walthowd/Philips-ep3200-ha/images/ESP12E-pinout.png

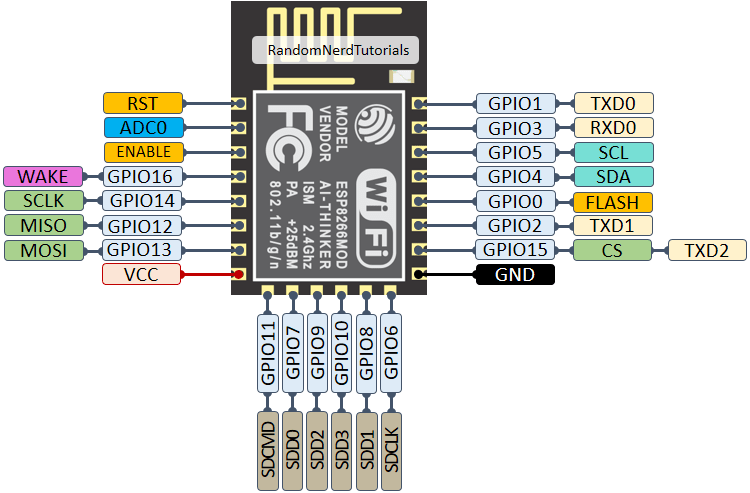
images/ESP12E-pinout.png
